SukbeomH/CxChanger/README.md

# [CxChanger]

저비용 예열식 다중 핫엔드 다중 재료 출력 솔루션 / Low-cost preheated multi-hotend multi-material printing solution.

[한국어](README.md) | [English](README.en.md)

Klipper 설정 파일: 기본 [`klipper/*.cfg`](klipper/)는 영어이며, 한국어 번역본은 [`klipper/ko/`](klipper/ko/), 영어 참조본은 [`klipper/en/`](klipper/en/)에 있습니다.

[CxChanger]는 FDM 3D 프린팅을 위한 다중 재료/다중 색상 솔루션입니다. 출력 중 서로 다른 필라멘트가 장착된 예열 완료 핫엔드 모듈을 툴 교체하여 빠른 다중 재료 출력을 구현합니다. 목표는 가능한 한 낮은 비용으로 단순하고 안정적인 다중 재료 출력을 구현하는 것입니다. 높은 호환성을 위해 툴 교체는 프린트헤드의 XY축 이동만으로 수행되며, 교체 구조는 핫엔드 모듈 자체와 독립적입니다. 따라서 핫엔드 모듈 고정 부품 등을 수정하면 다른 핫엔드도 호환시킬 수 있습니다.

프린트헤드

QQ20260404-193802

---

## 핵심 기능

- **자동 예열**: OrcaSlicer의 `Ooze Prevention`을 켜면, 사용자가 설정한 예열 시간에 맞춰 툴 교체 전에 예열 명령이 삽입됩니다. 교체 시 기존 핫엔드 모듈은 도크에 주차되고 대기 온도로 전환되며, 이미 예열된 핫엔드 모듈을 장착합니다. 다음 툴 교체까지의 시간이 가열 시간보다 짧으면 온도를 낮추지 않고 유지합니다.
- **언더액추에이티드 툴 교체 메커니즘**: 별도의 능동 구동 장치를 추가하지 않는 언더액추에이티드 설계입니다. 프린트헤드 자체의 XY축 이동과 도크의 기계적 상호작용을 이용해 툴 교체와 필라멘트 클램프/릴리스를 수행합니다.
- **자석식 Maxwell 운동학적 커플링**: 핫엔드 모듈 잠금에는 N52 자석과 [Maxwell 커플링](https://en.wikipedia.org/wiki/Kinematic_coupling) 위치 결정 구조를 함께 사용합니다. 프린트헤드 쪽에는 위치 결정 핀으로 구성된 세 개의 홈이 있고, 핫엔드 모듈 쪽에는 라운드 핀 머리로 구성된 볼이 있습니다. 자석으로 결합되면 핫엔드 모듈의 6자유도가 구속되며, 과구속이 발생하지 않습니다. 따라서 가공/조립 오차, 마모, 변형이 있어도 핫엔드 모듈이 스스로 유격을 줄이고 정밀하게 위치를 잡을 수 있습니다.
- **자동 노즐 오프셋 보정**: 보정기를 사용해 각 헤드의 XYZ축 오프셋을 T0 기준으로 보정합니다. [소형 볼 마이크로스위치 접촉식 노즐 오프셋 보정](https://github.com/Noisyfox/FoxChanger/tree/main/NozzleProbe) 또는 [비접촉 와전류 노즐 오프셋 보정](https://oshwhub.com/cxg01/project_lbabffjk)을 사용할 수 있습니다. 접촉식은 정확한 노즐 오프셋을 얻기 위해 노즐을 깨끗하게 청소해야 하며, 비접촉식은 노즐을 청소하지 않아도 사용할 수 있습니다. 매번 출력 전에 보정할 필요는 없고, 보통 최초 조립 직후나 노즐 충돌이 발생한 뒤에 보정합니다.

## 하드웨어 및 소프트웨어 요구 사항

### 하드웨어

- **프린터**: 원칙적으로 프린트헤드가 XY 이동을 할 수 있는 기종을 지원합니다. 예를 들면 Voron 2.4, Voron Trident, BigFish TT 등이 있습니다. 이 오픈소스 프로젝트는 프린트헤드와 기본 도크 설계만 제공합니다. 자신의 기종에 맞게 도크를 장착할 알루미늄 프로파일과 기타 호환 부품은 별도로 고정/수정해야 합니다.
- **메인보드**: 유선 가열 방식을 사용하므로 각 핫엔드 모듈에는 히터 카트리지와 서미스터가 하나씩 있습니다. 메인보드의 남는 포트를 활용하면 소수의 핫엔드 모듈을 확장할 수 있습니다. 더 많은 핫엔드 모듈을 확장하려면 [확장 보드](https://oshwhub.com/rayzark/project_qxihkkhj)를 제작해 히터봉 포트와 서미스터 포트를 늘려야 합니다.

### 소프트웨어

- **펌웨어**: 전체 툴 교체는 Klipper 매크로 명령으로 구현됩니다. 노즐 오프셋 보정이 필요하면 [toolchange](https://github.com/viesturz/klipper-toolchanger) 플러그인을 설치하고 자동 보정 매크로와 함께 사용해야 합니다.
- **슬라이서**: OrcaSlicer를 사용합니다. 다른 슬라이서는 직접 검토해야 합니다.

## 구성 개요

### 용어

- **프린트헤드(toolhead)**: XY 이동을 담당하며 핫엔드 모듈을 장착하는 캐리지입니다.
- **핫엔드 모듈(hotend module)**: 핫엔드, PTFE 튜브, 히터 및 서미스터 배선으로 구성된 교체 대상 물리 부품입니다.
- **툴(tool, `T0`-`T3`)**: Klipper와 OrcaSlicer에서 핫엔드 모듈을 선택하는 논리 식별자입니다. 이 문서에서 “툴 교체”는 한 핫엔드 모듈을 도크에 주차하고 다른 모듈을 장착하는 동작을 뜻합니다.
- **`UNTOOL`**: 현재 툴의 핫엔드 모듈을 도크에 주차하는 매크로입니다.

### 구성 부품

- 프린트헤드: 핫엔드를 제외한 나머지 부품입니다.
- 핫엔드 모듈: 핫엔드, PTFE 튜브, 히터, 서미스터 배선을 포함합니다.
- 도크: 분리된 핫엔드를 보관합니다. 보관 중인 핫엔드의 노즐을 막아 누출을 방지하고, 냉각 팬으로 보관 중인 핫엔드를 냉각합니다. 챔버가 없는 경우 측면 원심 팬 하나로 모든 핫엔드를 냉각하고, 챔버가 있는 경우 도크마다 축류 팬 하나를 사용합니다.

### 부품

#### 출력 버전

- 1.5 x 5 mm 원통 핀(직경 x 길이): Maxwell 커플링 위치 결정 홈 구성용(x6)
- 3 x 6 mm 라운드 핀(직경 x 길이): Maxwell 커플링 위치 결정 볼 구성용(핫엔드당 3개)
- 5 x 20 mm 내나사 라운드 핀(직경 x 길이): 도크에 장착해 익스트루더 아이들러 암을 벌리는 용도(도크당 1개)
- 6 x 4 mm N52 자석(직경 x 두께): 핫엔드 모듈을 프린트헤드와 도크에 부착하는 용도(핫엔드당 3개, 도크당 1개, 프린트헤드 3개)
- M3 x 6 접시머리 나사
- M3 x 25 나사
- M3 x 8 나사
- M3 x 10 나사
- M3 x 12 나사
- M3 x 14 나사
- M3 x 20 나사
- M2.5 x 16 나사
- M2 x 8 나사
- M3 x 4 x 4 열삽입 너트
- HGX 익스트루더 기어 세트
- 4020 블로워 팬
- 2510 축류 팬
- Omron 마이크로스위치
- 10 x 2 mm 접착식 내열 실리콘 스트립(폭 x 두께)

#### CNC 버전

[`5.5-version-bom.xlsx`](5.5-version-bom.xlsx)를 참고하십시오.

## 설치 및 설정 가이드

### printer.cfg

기존 `printer.cfg`의 본문은 그대로 사용할 수 있습니다. 제공된 `printer.cfg`의 형식과 아래 안내를 참고해 수정하거나, 제공된 파일을 그대로 사용하되 자신의 메인보드 핀에 맞게 변경해도 됩니다.

1. `toolchange.cfg`와 `calibration.cfg`를 include합니다.
2. 추가 핫엔드 모듈은 `extruder1` 형식을 참고해 정의합니다. 히터와 서미스터 핀은 자신의 메인보드 배선에 맞게 지정합니다. E0 익스트루더를 공용으로 사용하고, 나머지는 가상 익스트루더로 설정합니다.
3. 프로브는 고정 마이크로스위치를 사용합니다. 출력 시작 시 모든 핫엔드는 도크에 보관되고, 노즐은 내열 실리콘 패드로 막혀 있습니다. 목표 온도에 도달한 뒤에야 핫엔드를 집어 들기 때문에 초기 누출 문제가 해결되고 와이핑이 필요 없습니다. 베드 레벨링 시에는 핫엔드를 집지 않으므로 이때 마이크로스위치가 프린트헤드의 최저점입니다. 다른 레벨링 방식은 아직 지원하지 않습니다. 제공된 probe 관련 설정, 특히 베드 메시와 레벨링 설정을 참고하는 것을 권장합니다. 주된 차이는 레벨링 전에 집고 있던 핫엔드를 먼저 내려놓는 부분입니다.
4. 도크 냉각 팬 설정을 추가합니다. 도크 냉각 팬과 히트브레이크 냉각 팬이 연동하는 익스트루더 목록에 모든 익스트루더를 추가합니다.
5. `printer.cfg`의 `PRINT_START` 매크로를 수정해, 출력 전에 사용할 핫엔드 모듈이 자동으로 프라이밍/퍼지 라인을 만들도록 합니다.
6. `printer.cfg`의 `PRINT_END` 매크로를 수정합니다. `UNTOOL` 명령을 추가해 출력 완료 후 활성 핫엔드 모듈이 자동으로 도크에 주차되도록 합니다. 모든 핫엔드 히터를 끄는 명령도 추가합니다.

### toolchange.cfg

1. `toolchange.cfg`를 추가합니다. 성공적으로 추가하면 대시보드에 `T0`, `T1`, `T2`, `UNTOOL` 명령이 나타납니다. 좌표를 조정하기 전에는 누르지 마십시오. 바로 충돌할 수 있습니다. `T0`를 누르면 T0 핫엔드 모듈을 장착하고, T0가 장착된 상태에서 `T1`을 누르면 T0를 도크에 주차한 뒤 T1을 장착합니다. `UNTOOL`은 현재 핫엔드 모듈을 도크에 주차합니다.
2. 도크를 고정하고 도크 좌표를 조정합니다. 핫엔드를 프린트헤드에 수동으로 장착한 뒤 프린트헤드를 X축 가장 오른쪽으로 이동하고, 다시 앞쪽으로 이동합니다. 핫엔드 잠금 나사가 도크의 큰 구멍을 정확히 통과할 수 있는 위치에 첫 번째 도크를 고정합니다. 이 위치가 첫 번째 도크 좌표입니다. 이후 핫엔드를 제거하고 전체 홈을 수행한 다음, 다시 핫엔드를 프린트헤드에 장착합니다. 앞서 찾은 도크 위치로 프린트헤드를 천천히 이동시켜 잠금 나사가 도크의 큰 구멍을 통과하게 하고, 이때의 좌표를 기록해 `toolchange.cfg`의 T0 도크 위치에 입력합니다. 도크 하나는 30 mm 폭을 차지하므로 나머지 도크 좌표는 등차수열로 계산할 수 있습니다. 오차가 있으면 각 도크 좌표를 직접 미세 조정합니다.

   

3. 좌표를 올바르게 설정한 뒤에는 정상 속도를 주석 처리하고 테스트 속도의 주석을 해제해 저속으로 교체 테스트를 합니다. 정렬이 맞지 않으면 바로 비상정지를 누를 수 있도록 하기 위한 절차입니다.
4. 테스트 속도에서 교체가 정상 동작하면 테스트 속도를 다시 주석 처리하고 정상 속도의 주석을 해제합니다. 자신의 장비에 맞는 더 적절한 속도는 직접 테스트해 조정할 수 있습니다.

### calibration.cfg

1. [toolchange](https://github.com/viesturz/klipper-toolchanger) 플러그인을 다운로드합니다.
2. `calibration.cfg`를 추가합니다.
3. XYZ 홈을 수행합니다. 레벨링이 끝나면 보정기를 고정하고 `T0`를 눌러 첫 번째 핫엔드 모듈을 장착합니다. 노즐 끝이 보정기 중심 바로 위 약 1 mm 지점에 오도록 이동한 뒤, 이때의 좌표를 기록해 `calibration.cfg`의 보정기 좌표 위치에 입력합니다. 보정 중 도크 안의 다른 핫엔드 모듈과 충돌하지 않도록 도크 범위 밖의 안전 위치도 직접 정의해야 합니다.
4. 좌표 설정 후 `CALIBRATE_TOOL TOOL=_`을 입력하면 지정한 툴을 보정할 수 있습니다. T0를 먼저 보정해야 합니다. `CALIBRATE_ALL_TOOLS`를 입력하면 설정된 모든 툴을 보정할 수 있습니다. 보정 완료 후 오프셋은 자동 저장됩니다.

### OrcaSlicer

1. 프린터 프로필의 `Machine G-code`에서 `Machine start G-code`와 `Change filament G-code`를 수정하고, 핫엔드 모듈 수에 맞게 익스트루더를 추가합니다. 각 툴 교체의 필라멘트 리트랙션 길이도 설정합니다. 작성자는 2 mm로 설정했습니다.

- `Machine start G-code`, 자신의 핫엔드 모듈 수에 맞게 수정:

```Gcode
   ; 각 툴의 초기 레이어 온도와 실제 사용 여부를 개별 파라미터로 전달합니다.
PRINT_START BED=[first_layer_bed_temperature] INITIAL_TOOL=[initial_tool] T0_TEMP={nozzle_temperature_initial_layer[0]} T0_USED={is_extruder_used[0]} T1_TEMP={nozzle_temperature_initial_layer[1]} T1_USED={is_extruder_used[1]} T2_TEMP={nozzle_temperature_initial_layer[2]} T2_USED={is_extruder_used[2]} T3_TEMP={nozzle_temperature_initial_layer[3]} T3_USED={is_extruder_used[3]} T4_TEMP={nozzle_temperature_initial_layer[4]} T4_USED={is_extruder_used[4]}
```

- `Change filament G-code`:

```Gcode
M104 S{nozzle_temperature[next_extruder]} T{next_extruder}
T{next_extruder}
```

2. 공정 프로필의 멀티머티리얼 설정에서 `Prime Tower`를 켭니다. 필라멘트와 파라미터가 잘 조정되어 있고 모델에 빠르고 미세한 압출이 포함되지 않는다면, 모델을 도크 옆으로 옮기고 `Prime Tower`를 끈 상태로 출력하는 것도 시도할 수 있습니다. 같은 설정 영역에서 `Ooze Prevention`도 켭니다. 작성자는 연화 온도 -180, 예열 시간 35초로 설정했으며, 자신의 핫엔드 모듈 가열 속도에 맞게 수정해야 합니다.

## 주의 사항

- 출력 부품은 ABS로 출력하고, 벽 4겹과 60% 인필을 사용합니다.
- 익스트루더 스프링은 일반 익스트루더보다 더 강하게 조여야 합니다. 공간을 줄이기 위해 레버 암 길이가 짧아졌기 때문에, 같은 예압에서는 일반 익스트루더보다 클램프력이 낮습니다.
- 열전도 효율을 줄이기 위해 사용하는 TZ2.0 핫엔드는 히터 블록을 고정하는 나사 2개를 제거하고 측면 세트스크류만으로 고정해야 합니다.
- 자석은 도면대로 엄격하게 설치해야 합니다. 어떤 자석은 끝까지 눌러 넣고, 어떤 자석은 특정 면과 평면이 맞아야 합니다. 올바르게 조립되면 핫엔드 조립체 쪽 라운드 핀만 백플레이트 쪽 원통 핀 홈과 접촉하고, 자석 사이에는 약간의 간격이 남습니다. 그래야 Maxwell 커플링 위치 결정의 자동 유격 제거 기능이 작동합니다. 핫엔드를 흔들어 유격이 있는지 확인할 수 있습니다. 유격이 있으면 조립이 올바른지 확인해야 합니다. 출력 중 정밀도가 나빠지면 위치 결정 조립 상태를 확인하십시오. 자석 접착이 풀려 밀려 나오면서 반대쪽 자석과 접촉해 Maxwell 커플링이 무효화되는 문제가 발생하기 쉽습니다.
- 핫엔드 조립체를 도크 구멍에 걸기 위한 후크 나사는 12.9등급 육각렌치 볼트(컵 헤드)를 사용해야 도크 안에서 자석에 잘 붙습니다. 304 스테인리스 나사는 정상적으로 자석에 붙지 않습니다.
