SukbeomH/CxChanger/5.5-version-bom.xlsx

项目号 | 零件号 | 数量 | 价格 | 链接
HGX挤出齿轮套件 | 17 44双联齿轮 | 1 | 35.5 | https://item.taobao.com/item.htm?id=682175013983
 | 36齿挤出齿轮 | 2
 | 直径3长16圆柱销 | 2
 | 轴承外径6内径3厚2.5 | 4
 | 压簧 | 1
 | 直径3长24圆柱销 | 1
打印件 | 热端固定件 | 1
 | 停靠坞 | 数量根据自己需要来
 | 风道改 | 1
嘉立创拼版CNC | 顶部磁铁固定板 | 1 | 10 | 用上每个月两次的免费打样，加自己攻丝。不能自己攻丝的嘉立创1块钱攻一个（总共5个M3螺丝孔）
 | 弹簧撑板 | 1
 | 摆杆内（CNC） | 1
 | 摆杆内（CNC） | 1
 | 简化盖板 | 1
 | 打印头背板 | 1
 | 简化盖板 | 1
 | 铁氟龙管内径2外径4 | 热端固定件打印件内壁填充
 | 圆柱销直径1.5长5 | 用于构成麦克斯韦耦合定位的槽（×6） |  | https://detail.tmall.com/item.htm?id=1013104858939
 | 内螺纹圆头销M3外径5长18 | 装配于停靠坞上用于撑开挤出机摆臂（一个停靠坞1个） |  | https://detail.tmall.com/item.htm?id=864132087543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
 | 圆头销直径3长4 | 用于构成麦克斯韦耦合定位的球（一个热端3个） |  | https://detail.tmall.com/item.htm?id=868817943817
 | TZ2.0 | 数量根据自己需要来
 | N52磁铁直径6厚4 | 用于吸附热端模块到打印头上和停靠坞上（一个热端3个，一个停靠坞1个，打印头3个） |  | https://item.taobao.com/item.htm?id=968742198263
 | 2510风扇 | 1
 | 36圆饼步进电机 | 1
 | 微动开关 | 1
 | M4六角隔离柱10 | 2 |  | https://item.taobao.com/item.htm?abbucket=19&id=790190576194&ns=1&skuId=5961506598999&xxc=taobaoSearch
 | M4六角隔离柱14 | 1
 | M4带孔螺栓 | 1
 | 4020离心风扇 | 1
 | 杯头M3*8 | 2
 | M4螺母 | 1
 | 半圆头M3*22 | 7
 | 杯头M3*15 | 3
 | 杯头M2.5*14 | 2
 | M3螺母 | 5
 | 杯头M3*6 | 1
 | 杯头M3*10 | 3
 | 杯头M2*8 | 2
 | 停靠坞没有统一设计，这里不列举，螺丝种类自己判断
