SukbeomH/CxChanger/panelized-5.5-and-5.1-versions/5.1-cover-plate-PB1.step

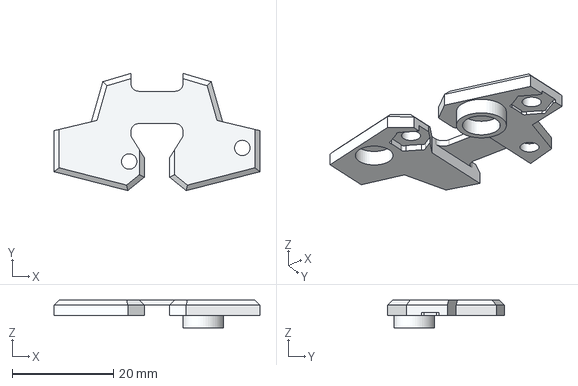
[picture p1: CAD file, 2026-07-12]
panelized-5.5-and-5.1-versions/5.1-cover-plate-PB1.step
40.8 x 23.2 x 5.50 mm
