SukbeomH/CxChanger/panelized-5.5-and-5.1-versions/5.1-idler-arm-PB2-thread-recognizable.step

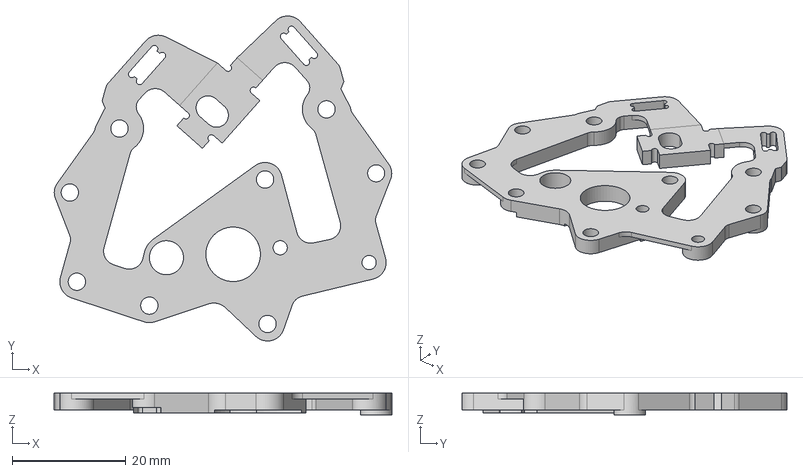
[picture p2: CAD file, 2026-07-12]
panelized-5.5-and-5.1-versions/5.1-idler-arm-PB2-thread-recognizable.step
59.4 x 57.2 x 3.80 mm
实体1 (2)
实体1 (4)
实体1 (1)
实体1 (3)
