SukbeomH/CxChanger/panelized-5.5-and-5.1-versions/5.1-backplate-2.5mm-belt-slot.step

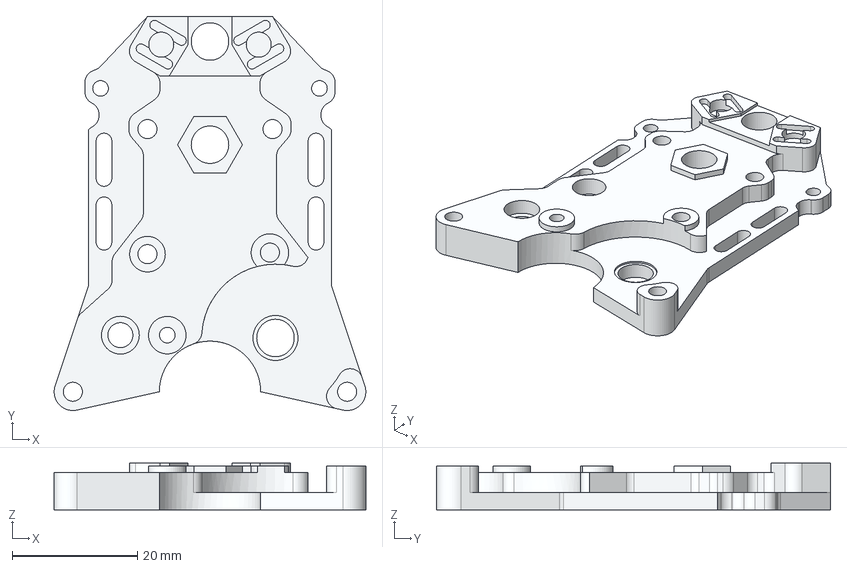
[picture p3: CAD file, 2026-07-12]
panelized-5.5-and-5.1-versions/5.1-backplate-2.5mm-belt-slot.step
49.8 x 63.0 x 7.50 mm
