SukbeomH/CxChanger/klipper/en/printer.cfg

[virtual_sdcard]
path: /usr/share/printer_data/gcodes

[pause_resume]

[display_status]

[gcode_macro CANCEL_PRINT]
description: Cancel the active print
rename_existing: CANCEL_PRINT_BASE
gcode:
  TURN_OFF_HEATERS
  CANCEL_PRINT_BASE
  G91
  G1 Z10 F600 ; Lift the nozzle 10 mm to avoid heat damage to the model
  UNTOOL
  M106 S0

[force_move]
enable_force_move: True

#####################################################################
#                               File includes                               #
#####################################################################
[include toolchange.cfg]
[include calibration.cfg]
#[include idm.cfg]
#####################################################################
#                               Mainboard configuration                               #
#####################################################################
[mcu]
serial:/dev/serial/by-id/usb-Klipper_stm32f407xx_37001E001650334636343620-if00

#[mcu host]
#serial: /tmp/klipper_host_mcu

#####################################################################
#                            Expansion board configuration                             #
#####################################################################
#[mcu expander]
# Enter the new board ID obtained in the first step here
#serial: /dev/serial/by-id/usb-Klipper_stm32f072xb_3F0035000357465036383420-if00
#####################################################################
#                            Printer model and acceleration                            #
#####################################################################
[printer]                       # printer settings
kinematics: corexy              # kinematics type, such as Cartesian or CoreXY; Cartesian uses cartesian
max_velocity: 400               # maximum printer speed
max_accel: 20000                # maximum acceleration
max_z_velocity: 30              # maximum Z-axis speed
max_z_accel: 300                # maximum Z-axis acceleration
square_corner_velocity: 5.0     # square-corner velocity; a smaller value helps reduce inertia from a heavy bed
#####################################################################
#                             Temperature monitoring                               #
#####################################################################
[temperature_sensor MCU]
sensor_type: temperature_mcu

[temperature_sensor FLY-Pi]
sensor_type: temperature_host

#[temperature_sensor Fly-C8p]     # FLY mainboard temperature, rename if desired
#sensor_type: temperature_mcu     # associated MCU, default

# [temperature_sensor Box]          # enclosure temperature; requires adding a temperature sensor, reference configuration
# sensor_type: ATC Semitec 104GT-2  # sensor type
# sensor_pin: PA4                   # signal port

#####################################################################
#             X/Y stepper settings (X/Y Stepper Settings)                 #
#####################################################################
#   B Motor ---- Motor A
#   |                  |
#   |------extruder-------|
#   |                  |
#   |                  |
#          front
#####################################################################
#                  X-axis stepper motor (B Motor)                            #
#####################################################################
[stepper_x]
step_pin: PB9                       # X-axis motor step pin
dir_pin: PE0                        # X-axis motor direction pin; verify direction on your machine, ! reverses direction
enable_pin: !PE1                    # X-axis motor enable pin; enable pins require ! or the motor will not work
rotation_distance: 40               # drive pulley circumference in mm; 2GT-20T is 40, 2GT-16T is 32
microsteps: 32                      # motor microstep setting; higher microsteps improve quality but increase controller load
full_steps_per_rotation: 200        # full steps per motor revolution; 1.8-degree motor: 200, 0.9-degree motor: 400
endstop_pin: PF1                    # physical X endstop pin
position_min: -5                   # minimum X-axis travel
position_endstop: 240              # endstop position
position_max: 240                  # maximum X-axis travel
homing_speed: 80                   # homing speed; maximum is 100
homing_retract_dist: 5             # retract distance after first homing-switch trigger
#--------------------------------------------------------------------
[tmc2209 stepper_x]                 # X driver configuration - TMC2209
uart_pin: PG13                      # UART port pin definition
interpolate: False                  # whether to enable 256-microstep interpolation; disabling is recommended, True enables and False disables
run_current: 1.2                   # motor run current, mA
sense_resistor: 0.110               # do not change the driver sense resistor
#stealthchop_threshold: 100          # stealthChop threshold; set to 0 if quiet mode is not needed
#####################################################################
#                  Y-axis stepper motor (A Motor)                            #
#####################################################################
[stepper_y]
step_pin: PB8                       # Y-axis motor step pin
dir_pin: PG11                      # Y-axis motor direction pin; verify direction on your machine, ! reverses direction
enable_pin: !PG12                   # Y-axis motor enable pin; enable pins require ! or the motor will not work
rotation_distance: 40               # drive pulley circumference in mm; 2GT-20T is 40, 2GT-16T is 32
microsteps: 32                      # motor microstep setting; higher microsteps improve quality but increase controller load
full_steps_per_rotation: 200        # full steps per motor revolution; 1.8-degree motor: 200, 0.9-degree motor: 400
endstop_pin: PC2
position_min: -33                   # minimum Y-axis travel
position_endstop: 230               # endstop position
position_max: 230                   # maximum Y-axis travel
homing_speed: 80                    # homing speed; maximum is 100
homing_retract_dist: 5              # retract distance after first homing-switch trigger 5
#--------------------------------------------------------------------
[tmc2209 stepper_y]                 # Y driver configuration - TMC2209
uart_pin: PG10                      # UART port pin definition
interpolate: False                  # whether to enable 256-microstep interpolation
run_current: 1.2                    # motor run current, mA
sense_resistor: 0.110               # do not change the driver sense resistor
#stealthchop_threshold: 100          # stealthChop threshold; set to 0 if quiet mode is not needed
#####################################################################
#                           Z-axis stepper motor                              #
#####################################################################
##    Z stepper motor - front left
[stepper_z]
step_pin: PC6                 # Z-axis motor step pin
dir_pin:  !PA15              # Z-axis motor direction pin; verify direction on your machine, ! reverses direction
enable_pin: !PD0              # Z-axis motor enable pin; enable pins require ! or the motor will not work
rotation_distance: 8          # lead screw lead is 8; adjust for your setup, three places must be changed in total
full_steps_per_rotation: 200  # full steps per motor revolution; 1.8-degree motor: 200, 0.9-degree motor: 400)
microsteps: 32                # motor microstep setting; higher microsteps improve quality but increase controller load
endstop_pin: probe:z_virtual_endstop            # endstop pin; normally-closed is recommended, add ! to invert, position io-1
position_min: -10             # minimum Z-axis travel; nozzle-cleaning setups usually need about -5
position_max: 200             # maximum Z-axis travel
homing_speed: 10               # homing speed, maximum 20
second_homing_speed: 3        # second homing speed, maximum 10
homing_retract_dist: 3        # retract distance
#--------------------------------------------------------------------
[tmc2208 stepper_z]
uart_pin: PA14                # driver UART port
interpolate: false            # 256-microstep interpolation
run_current: 0.8              # run current, mA
sense_resistor: 0.110         # do not change the driver sense resistor
#--------------------------------------------------------------------
##    Z1 stepper motor - rear
[stepper_z1]
step_pin: PC7                # Z1-axis motor step pin
dir_pin:  !PD3              # Z1-axis motor direction pin; verify direction on your machine, ! reverses direction
enable_pin: !PD4             # Z1-axis motor enable pin; enable pins require ! or the motor will not work
rotation_distance: 8          # lead screw lead is 8
full_steps_per_rotation: 200  # full steps per motor revolution; 1.8-degree motor: 200, 0.9-degree motor: 400
microsteps: 32                # motor microstep setting; higher microsteps improve quality but increase controller load
#--------------------------------------------------------------------
[tmc2208 stepper_z1]
uart_pin: PD1               # driver UART port
interpolate: false            # 256-microstep interpolation
run_current: 0.8              # run current, mA
sense_resistor: 0.110         # do not change the driver sense resistor
#--------------------------------------------------------------------
##    Z2 stepper motor - front right
[stepper_z2]
step_pin: PA8                 # Z2-axis motor step pin
dir_pin: !PD6                # Z2-axis motor direction pin; verify direction on your machine, ! reverses direction
enable_pin: !PD7             # Z2-axis motor enable pin; enable pins require ! or the motor will not work
rotation_distance: 8          # lead screw lead is 8
full_steps_per_rotation: 200  # full steps per motor revolution; 1.8-degree motor: 200, 0.9-degree motor: 400
microsteps: 32                # motor microstep setting; higher microsteps improve quality but increase controller load
#--------------------------------------------------------------------
[tmc2208 stepper_z2]
uart_pin: PD5                 # driver UART port
interpolate: false            # 256-microstep interpolation
run_current: 0.8              # run current, mA
sense_resistor: 0.110         # do not change the driver sense resistor
#####################################################################
#                     E0 extruder settings （E0 Settings）                   #
#####################################################################

[extruder]
step_pin: PD15                      # extruder motor step pin
dir_pin: PG7                        # extruder motor direction pin
enable_pin: !PG8                    # extruder motor enable pin
rotation_distance: 55               # rotation distance value
gear_ratio: 44:10, 37:17            # gear ratio; Galileo is 7.5:1 and this line should be commented out; BMG is 50:17, output shaft front, input shaft rear
microsteps: 32                      # motor microstep setting; higher microsteps improve quality but increase controller load
full_steps_per_rotation: 200        # full steps per revolution; 200 for 1.8 degrees, 400 for 0.9 degrees
nozzle_diameter: 0.400              # nozzle diameter
filament_diameter: 1.75             # filament diameter
heater_pin: PF7                     # heater cartridge pin
sensor_type: ATC Semitec 104GT-2    # sensor type  (#Generic 3950, ATC Semitec 104GT-2， PT1000)
sensor_pin: PA0                     # sensor pin, connected to ADC_0
min_temp: -273                      # minimum temperature; note that measured temperature outside the configured range triggers emergency stop
max_temp: 350                       # maximum temperature; note that measured temperature outside the configured range triggers emergency stop
max_power: 1.0                      # maximum power
min_extrude_temp: -273              # minimum extrusion temperature
#nozzle temperature PID calibration command：  "PID_CALIBRATE HEATER=extruder TARGET=245
#control = pid                # PID nozzle temperature auto-calibration item; commented after PID calibration completes
#pid_kp = 26.213              # PID nozzle temperature auto-calibration item; commented after PID calibration completes
#pid_ki = 1.304               # PID nozzle temperature auto-calibration item; commented after PID calibration completes
#pid_kd = 131.721             # PID nozzle temperature auto-calibration item; commented after PID calibration completes

#--------------------------------------------------------------------
[tmc2208 extruder]                  # extruder driver configuration
uart_pin: PG6                      # UART port pin definition
interpolate: False                  # whether to enable 256-microstep interpolation; True enables and False disables
run_current: 0.8                    # motor run current
sense_resistor: 0.110               # do not change the driver sense resistor
#stealthchop_threshold: 500          # stealthChop threshold; not recommended for the extruder, set to 0 if quiet mode is not needed

#####################################################################
#                     E1 extruder settings （E1 Settings）                   #
#####################################################################

[extruder1]
nozzle_diameter: 0.400              # nozzle diameter
filament_diameter: 1.75             # filament diameter
heater_pin: PF6                     # heater cartridge pin
sensor_type: ATC Semitec 104GT-2    # sensor type  (#Generic 3950, ATC Semitec 104GT-2， PT1000)
sensor_pin: PC1                     # sensor pin, connected to ADC_0
min_temp: -273                      # minimum temperature; note that measured temperature outside the configured range triggers emergency stop
max_temp: 350                       # maximum temperature; note that measured temperature outside the configured range triggers emergency stop
max_power: 1.0                      # maximum power
min_extrude_temp: 180               # minimum extrusion temperature; the extruder can extrude only after reaching this temperature
#nozzle temperature PID calibration command：  "PID_CALIBRATE HEATER=extruder1 TARGET=245
#control = pid                # PID nozzle temperature auto-calibration item; commented after PID calibration completes
#pid_kp = 26.213              # PID nozzle temperature auto-calibration item; commented after PID calibration completes
#pid_ki = 1.304               # PID nozzle temperature auto-calibration item; commented after PID calibration completes
#pid_kd = 131.721             # PID nozzle temperature auto-calibration item; commented after PID calibration completes

#####################################################################
#                     E2 extruder settings （E2 Settings）                   #
#####################################################################

[extruder2]
nozzle_diameter: 0.400              # nozzle diameter
filament_diameter: 1.75             # filament diameter
heater_pin: PE6                     # heater cartridge pin
sensor_type: ATC Semitec 104GT-2    # sensor type  (#Generic 3950, ATC Semitec 104GT-2， PT1000)
sensor_pin: PC0                     # sensor pin, connected to ADC_0
min_temp: -273                      # minimum temperature; note that measured temperature outside the configured range triggers emergency stop
max_temp: 350                       # maximum temperature; note that measured temperature outside the configured range triggers emergency stop
max_power: 1.0                      # maximum power
min_extrude_temp: 180               # minimum extrusion temperature; the extruder can extrude only after reaching this temperature
#nozzle temperature PID calibration command：  "PID_CALIBRATE HEATER=extruder2 TARGET=245
#control = pid                # PID nozzle temperature auto-calibration item; commented after PID calibration completes
#pid_kp = 26.213              # PID nozzle temperature auto-calibration item; commented after PID calibration completes
#pid_ki = 1.304               # PID nozzle temperature auto-calibration item; commented after PID calibration completes
#pid_kd = 131.721             # PID nozzle temperature auto-calibration item; commented after PID calibration completes

#####################################################################
#                     E3 extruder settings （E3 Settings）                   #
#####################################################################

[extruder3]
nozzle_diameter: 0.400              # nozzle diameter
filament_diameter: 1.75             # filament diameter
heater_pin: PE5                     # heater cartridge pin
sensor_type: ATC Semitec 104GT-2    # sensor type  (#Generic 3950, ATC Semitec 104GT-2， PT1000)
sensor_pin: PF10                    # sensor pin, connected to ADC_0
min_temp: -273                      # minimum temperature; note that measured temperature outside the configured range triggers emergency stop
max_temp: 350                       # maximum temperature; note that measured temperature outside the configured range triggers emergency stop
max_power: 1.0                      # maximum power
min_extrude_temp: 180               # minimum extrusion temperature; the extruder can extrude only after reaching this temperature
#nozzle temperature PID calibration command：  "PID_CALIBRATE HEATER=extruder3 TARGET=245
#control = pid                # PID nozzle temperature auto-calibration item; commented after PID calibration completes
#pid_kp = 26.213              # PID nozzle temperature auto-calibration item; commented after PID calibration completes
#pid_ki = 1.304               # PID nozzle temperature auto-calibration item; commented after PID calibration completes
#pid_kd = 131.721             # PID nozzle temperature auto-calibration item; commented after PID calibration completes

#####################################################################
#                            heated bed configuration                                #
#####################################################################

[heater_bed]
heater_pin: PE3              # heated bed port
sensor_type: Generic 3950    # heated bed sensor type
sensor_pin:  PF3             # heated bed sensor port
max_power: 1.0               # heated bed power
min_temp: -273                  # minimum temperature; note that measured temperature outside the configured range triggers emergency stop
max_temp: 100                # maximum temperature; note that measured temperature outside the configured range triggers emergency stop
# heated bed temperature PID calibration command：  "PID_CALIBRATE HEATER=heater_bed TARGET=100"
#control: pid                # PID heated-bed temperature auto-calibration item; commented after PID calibration completes
#pid_kp: 58.437              # PID heated-bed temperature auto-calibration item; commented after PID calibration completes
#pid_ki: 2.347               # PID heated-bed temperature auto-calibration item; commented after PID calibration completes
#pid_kd: 363.769             # PID heated-bed temperature auto-calibration item; commented after PID calibration completes

#####################################################################
#                            fan configuration                                #
#####################################################################
[fan]                        # part-cooling fan
pin: PF8                     # signal port
kick_start_time: 0.5         # startup time; do not change
off_below: 0.10              # do not change
#--------------------------------------------------------------------
[heater_fan hotend_fan]
pin: PF9                     # signal port
max_power: 1                 # maximum speed
kick_start_time: 0.5         # startup time; do not change
heater: extruder,extruder1,extruder2,extruder3             # associated device: extruder
heater_temp: 50              # extruder temperature at which the fan starts
fan_speed: 0.6               # fan speed
#--------------------------------------------------------------------
[heater_fan dock_fan]
pin: PA2                     # signal port
max_power: 1.0               # maximum speed
kick_start_time: 0.5         # startup time; do not change
heater: extruder,extruder1,extruder2,extruder3              # associated device: extruder
heater_temp: 50              # extruder temperature at which the fan starts
fan_speed: 1.0               # fan speed
#--------------------------------------------------------------------

[controller_fan driver_fan]
pin: PA1                     # replace with the actual controller-fan pin on your board
max_power: 1.0              # full-speed fan power
idle_timeout: 60            # delay after steppers become idle (seconds)

#####################################################################
#                           leveling sensor                               #
#####################################################################
[probe]
pin: PF2
x_offset: 2.88                  # X-axis sensor offset relative to nozzle
y_offset: 11.63                 # Y-axis sensor offset relative to nozzle
#z_offset: 5.07              # Z-axis sensor offset relative to nozzle
#PROBE_CALIBRATE, probe calibration
speed: 10                     # leveling speed
samples: 3                   # number of samples
samples_result: median       # sample result method; default median
sample_retract_dist: 3.0     # leveling retract distance
lift_speed:8                # lift speed
samples_tolerance: 0.005     # sample tolerance; too-small values may increase sample count
samples_tolerance_retries: 6 # number of retries after exceeding tolerance

#####################################################################
#                               homing                                #
#####################################################################
[homing_override]
axes: z
set_position_z: 0
gcode:
    G91
    G1 Z10 F600
    G90

    # check whether X is homed; home it if not
    {% if "X" not in printer.toolhead.homed_axes %}
        G28 Y
        G91
        G1 Y-40 F2400
        G90
    {% endif %}
    M400

    # check whether X is homed; home it if not
    {% if "X" not in printer.toolhead.homed_axes %}
        G28 X
        G91
        G1 X-5 F1200
        G90
    {% endif %}

    UNTOOL  # run your tool-unload macro

    # move to the center of the bed for Z homing; adjust X150 Y150 for your bed size
    G0 X{ printer.toolhead.axis_maximum.x/2 } Y{ printer.toolhead.axis_maximum.y/2 } F6000

    # perform actual Z homing
    G28 Z

    # lift slightly after homing
    G1 Z20 F600

#####################################################################
#   3-Z leveling
#####################################################################
[z_tilt]
# z_positions: physical lead-screw coordinates, rotation-center points
# imagine the XY coordinate of the point where the nozzle would be directly above the lead screw.
# Note: these points are usually outside the print area.
z_positions:
    -10, -5           # lead screw 1 (stepper_z) physical position
    117.5, 255        # lead screw 2 (stepper_z1)  physical position
    245, 10           # lead screw 3 (stepper_z2) physical position

# points: probe measurement points, where the probe touches the bed
points:
    10, 10            # first measurement point (near the rear-left lead screw)
    117.5, 205        # second measurement point (near the rear-right lead screw)
    225, 10           # third measurement point (near the front-center lead screw)

speed: 400            # move speed between measurements
horizontal_move_z: 10 # lift height before measurement
retries: 6            # allowed retry count until accuracy is reached
retry_tolerance: 0.01 # accuracy requirement
#####################################################################
#                              bed mesh calibration
#####################################################################
[bed_mesh]
speed: 300                   # calibration speed
horizontal_move_z: 10        # Z lift height before the probe moves to the next point
mesh_min: 10,10              # minimum calibration point coordinates, X and Y
mesh_max: 220, 225           # maximum calibration point coordinates, X and Y
probe_count: 5,5             # number of sample points; 4x4 is 16 points
mesh_pps: 2,2                # additional interpolated sample points
algorithm: bicubic           # algorithm model
bicubic_tension: 0.2         # do not change the algorithm interpolation setting

#####################################################################
#                    park the active tool (hotend module) before probing
#####################################################################
[gcode_macro Z_TILT_ADJUST]
rename_existing: Z_TILT_ADJUST_BASE
gcode:
    UNTOOL        # first make sure no tool is attached
    Z_TILT_ADJUST_BASE {rawparams}  # then run the original leveling command

[gcode_macro BED_MESH_CALIBRATE]
rename_existing: BED_MESH_CALIBRATE_BASE
gcode:
    UNTOOL        # first make sure no tool is attached
    BED_MESH_CALIBRATE_BASE {rawparams} # then run the original leveling command

#####################################################################
#                              Accelerometer
#####################################################################
[lis2dw]
i2c_address: 25
# i2c_mcu: toolhead          # Defaults to the main MCU when omitted
# i2c_bus: i2c3              # Try hardware I2C if software I2C fails
i2c_speed: 400000
i2c_software_scl_pin: PA9
i2c_software_sda_pin: PA10

[resonance_tester]
accel_chip: lis2dw
accel_per_hz: 50
probe_points: 120, 120, 20   # Set to the bed center with a safe Z height around 20 mm

[input_shaper]
# Leave empty until resonance calibration writes values through SAVE_CONFIG.

#####################################################################
#                           custom G-code macros                            #
#####################################################################

[gcode_macro PRINT_START]
description: Print-start macro: homing, leveling, independent material temperatures, and ordered priming lines
gcode:
    # ==========================================
    # 1. Priming-line parameters
    # ==========================================
    {% set cfg_start_x = params.START_X|default(10.0)|float %}
    {% set cfg_start_y = params.START_Y|default(5.0)|float %}
    {% set cfg_offset_y = params.OFFSET_Y|default(2.0)|float %}
    {% set cfg_length = params.LENGTH|default(50.0)|float %}
    {% set cfg_pre_extrude = params.PRE_EXTRUDE|default(3.0)|float %}
    {% set cfg_retract = 0 %}
    {% set cfg_speed_xy = 24000 %}
    {% set cfg_speed_z = 3000 %}

    # ==========================================
    # 2. Read slicer parameters and identify tools that are actually used
    # ==========================================
    {% set BED_TEMP = params.BED|default(60)|float %}
    {% set INITIAL_TOOL = params.INITIAL_TOOL|default("0")|string %}
    {% set ns = namespace(tools="", temps="") %}

    # Check the five supported slicer slots, T0 through T4.
    {% for i in range(5) %}
        {% set temp_key = 'T' ~ i ~ '_TEMP' %}
        {% set used_key = 'T' ~ i ~ '_USED' %}
        {% set ext_name = "extruder" if i == 0 else "extruder" ~ i %}

        {% if temp_key in params and ext_name in printer.heaters.available_heaters %}
            {% set t_val = params[temp_key]|float %}
            {% set is_used = params[used_key]|default("1")|string|lower %}
            {% if t_val > 0 and (is_used == "1" or is_used == "true") %}
                {% set ns.tools = ns.tools ~ i ~ "," %}
                {% set ns.temps = ns.temps ~ t_val ~ "," %}
            {% endif %}
        {% endif %}
    {% endfor %}

    {% set tool_list = ns.tools.strip(',').split(',') %}
    {% set temp_list = ns.temps.strip(',').split(',') %}

    # Fallback: heat only the initial tool to 200 C if no valid tool was matched.
    {% if tool_list|length == 1 and tool_list[0] == "" %}
        {% set tool_list = [INITIAL_TOOL] %}
        {% set temp_list = [200.0] %}
    {% endif %}

    # ==========================================
    # 3. Preheat the bed, home, and level
    # ==========================================
    BED_MESH_CLEAR
    M140 S{BED_TEMP}
    G28
    Z_TILT_ADJUST
    G28 Z
    G1 Z20 F{cfg_speed_z}
    BED_MESH_PROFILE LOAD=default
    M190 S{BED_TEMP}

    # ==========================================
    # 4. Heat all used tools to their independent temperatures
    # ==========================================
    # Start all heaters concurrently.
    {% for i in range(tool_list|length) %}
        {% if tool_list[i] != "" and temp_list[i] != "" %}
            M104 S{temp_list[i]} T{tool_list[i]}
        {% endif %}
    {% endfor %}

    # Then wait for each heater to reach its target.
    {% for i in range(tool_list|length) %}
        {% if tool_list[i] != "" and temp_list[i] != "" %}
            M109 S{temp_list[i]} T{tool_list[i]}
        {% endif %}
    {% endfor %}

    # ==========================================
    # 5. Switch tools in order and create priming lines
    # ==========================================
    SAVE_GCODE_STATE NAME=print_start_state
    G90
    G92 E0
    {% set ns_line = namespace(line_index=0) %}

    # 5.1 Prime non-initial tools first.
    {% for tool in tool_list %}
        {% if tool != "" and tool != INITIAL_TOOL %}
            T{tool}
            {% set current_y = cfg_start_y + (ns_line.line_index * cfg_offset_y) %}

            G1 Z5.0 F{cfg_speed_z}
            G1 X{cfg_start_x} Y{current_y} F{cfg_speed_xy}
            G1 Z0.28 F1500

            G91
            G1 E{cfg_pre_extrude} F300
            G1 X{cfg_length * 0.6} E{cfg_length * 0.12} F1000
            G1 X{cfg_length * 0.4} E{cfg_length * 0.05} F1500
            G1 E-{cfg_retract} F2100
            G1 Z2.0 F{cfg_speed_z}

            G90
            G92 E0
            M104 S0 T{tool}
            {% set ns_line.line_index = ns_line.line_index + 1 %}
        {% endif %}
    {% endfor %}

    # 5.2 Prime the initial tool last so it is ready to print immediately.
    {% if INITIAL_TOOL in tool_list %}
        T{INITIAL_TOOL}
        {% set current_y = cfg_start_y + (ns_line.line_index * cfg_offset_y) %}

        G1 Z5.0 F{cfg_speed_z}
        G1 X{cfg_start_x} Y{current_y} F{cfg_speed_xy}
        G1 Z0.28 F1500

        G91
        G1 E{cfg_pre_extrude} F300
        G1 X{cfg_length * 0.6} E{cfg_length * 0.12} F1000
        G1 X{cfg_length * 0.4} E{cfg_length * 0.05} F1500
        G1 E-{cfg_retract} F2100
        G1 Z2.0 F{cfg_speed_z}

        G90
        G92 E0
    {% endif %}

    # ==========================================
    # 6. Restore state and apply the initial-tool offset
    # ==========================================
    RESTORE_GCODE_STATE NAME=print_start_state

    {% if INITIAL_TOOL in tool_list %}
        {% set svv = printer.save_variables.variables %}
        {% set off_x = svv["t" ~ INITIAL_TOOL ~ "_offset_x"] | default(0.0) | float %}
        {% set off_y = svv["t" ~ INITIAL_TOOL ~ "_offset_y"] | default(0.0) | float %}
        {% set off_z = svv["t" ~ INITIAL_TOOL ~ "_offset_z"] | default(0.0) | float %}

        SET_GCODE_OFFSET X={off_x} Y={off_y} Z={off_z} MOVE=0
        { action_respond_info("Initial tool T" ~ INITIAL_TOOL ~ " offset applied: X=" ~ off_x ~ " Y=" ~ off_y ~ " Z=" ~ off_z) }
    {% endif %}

    { action_respond_info("Priming complete. Current tool is T" ~ INITIAL_TOOL ~ "; ready to print.") }
#--------------------------------------------------------------------
[gcode_macro PRINT_END]
description: Print-end macro: park the active tool, turn off heaters, and lower the bed for easy part removal
gcode:
    # 1. get the configured printer bounds
    {% set max_x = printer.configfile.config["stepper_x"]["position_max"]|float %}
    {% set max_y = printer.configfile.config["stepper_y"]["position_max"]|float %}
    {% set max_z = printer.configfile.config["stepper_z"]["position_max"]|float %}

    # 2. park the active tool (hotend module) and reset offsets
    UNTOOL
    SET_GCODE_OFFSET X=0 Y=0 Z=0

    M400                              # wait for buffer to clear
    G92 E0                            # reset extruder position counter

    # 3. perform a small safe lift first, in relative coordinates
    G91                               # relative positioning
    # lift 5 mm if it does not exceed maximum height
    {% if printer.toolhead.position.z < (max_z - 5) %}
        G0 Z5 F3600
    {% endif %}

    # 4. turn off all heaters and fans
    M104 S0 T0
    M104 S0 T1
    M104 S0 T2
    M104 S0 T3
    M140 S0                           # turn off heated bed
    M106 S0                           # turn off part-cooling fan

    # 5. move to the part-removal position, in absolute coordinates
    G90                               # switch back to absolute coordinates
    {% set safe_z = max_z - 10 %}

    G0 X{max_x-5} Y{max_y-5} Z{safe_z} F6000

    # 6. post-processing
    M400                              # wait for movement to complete
    BED_MESH_CLEAR                    # clear bed mesh
    # M84                             # Optional: uncomment this line to disable motors for easier manual part removal

    { action_respond_info("Print complete. The bed has been lowered; remove the part.") }
#*# <---------------------- SAVE_CONFIG ---------------------->
#*# DO NOT EDIT THIS BLOCK OR BELOW. The contents are auto-generated.
#*#
#*# [heater_bed]
#*# control = pid
#*# pid_kp = 18.892
#*# pid_ki = 0.396
#*# pid_kd = 225.286
#*#
#*# [extruder]
#*# control = pid
#*# pid_kp = 23.799
#*# pid_ki = 6.102
#*# pid_kd = 23.204
#*#
#*# [probe]
#*# z_offset = -1.225
#*#
#*# [extruder1]
#*# control = pid
#*# pid_kp = 26.493
#*# pid_ki = 8.831
#*# pid_kd = 19.870
#*#
#*# [extruder2]
#*# control = pid
#*# pid_kp = 46.880
#*# pid_ki = 10.081
#*# pid_kd = 54.499
#*#
#*# [extruder3]
#*# control = pid
#*# pid_kp = 40.250
#*# pid_ki = 13.417
#*# pid_kd = 30.187
#*#
#*# [bed_mesh default]
#*# version = 1
#*# points =
#*# 	  -0.014690, -0.052190, -0.025940, -0.054690, -0.050940
#*# 	  -0.052190, -0.025940, -0.010940, -0.010940, 0.004060
#*# 	  -0.120940, -0.043440, -0.013440, 0.030310, 0.100310
#*# 	  -0.197190, -0.100940, -0.027190, 0.055310, 0.155310
#*# 	  -0.245940, -0.087190, 0.022810, 0.120310, 0.264060
#*# x_count = 5
#*# y_count = 5
#*# mesh_x_pps = 2
#*# mesh_y_pps = 2
#*# algo = bicubic
#*# tension = 0.2
#*# min_x = 10.0
#*# max_x = 220.0
#*# min_y = 10.0
#*# max_y = 225.0
#*#
#*# [input_shaper]
#*# shaper_type_x = mzv
#*# shaper_freq_x = 94.4
#*# shaper_type_y = mzv
#*# shaper_freq_y = 66.4
