SukbeomH/CxChanger/klipper/ko/printer.cfg

[virtual_sdcard]
path: /usr/share/printer_data/gcodes

[pause_resume]

[display_status]

[gcode_macro CANCEL_PRINT]
description: 현재 출력 취소
rename_existing: CANCEL_PRINT_BASE
gcode:
  TURN_OFF_HEATERS
  CANCEL_PRINT_BASE
  G91
  G1 Z10 F600 ; 모델의 열 손상을 방지하도록 노즐을 10 mm 상승
  UNTOOL
  M106 S0

[force_move]
enable_force_move: True

#####################################################################
#                               파일 include                               #
#####################################################################
[include toolchange.cfg]
[include calibration.cfg]
#[include idm.cfg]
#####################################################################
#                               메인보드 설정                               #
#####################################################################
[mcu]
serial:/dev/serial/by-id/usb-Klipper_stm32f407xx_37001E001650334636343620-if00

#[mcu host]
#serial: /tmp/klipper_host_mcu

#####################################################################
#                            확장 보드 설정                             #
#####################################################################
#[mcu expander]
# 첫 단계에서 얻은 새 보드 ID를 여기에 입력
#serial: /dev/serial/by-id/usb-Klipper_stm32f072xb_3F0035000357465036383420-if00
#####################################################################
#                            프린터 기종 및 가속도                            #
#####################################################################
[printer]                       # 프린터 설정
kinematics: corexy              # 키네마틱 구조: Cartesian, CoreXY 등. Cartesian은 cartesian 사용
max_velocity: 400               # 프린터 최대 속도
max_accel: 20000                # 최대 가속도
max_z_velocity: 30              # Z축 최대 속도
max_z_accel: 300                # Z축 최대 가속도
square_corner_velocity: 5.0     # 스퀘어 코너 속도; 값을 낮추면 무거운 베드 관성 영향을 줄일 수 있음
#####################################################################
#                             온도 모니터링                               #
#####################################################################
[temperature_sensor MCU]
sensor_type: temperature_mcu

[temperature_sensor FLY-Pi]
sensor_type: temperature_host

#[temperature_sensor Fly-C8p]     # FLY 메인보드 온도, 필요 시 이름 변경 가능
#sensor_type: temperature_mcu     # 연결된 MCU, 기본값

# [temperature_sensor Box]          # 챔버 내부 온도; 온도 센서 추가 필요, 참고 설정
# sensor_type: ATC Semitec 104GT-2  # 센서 유형
# sensor_pin: PA4                   # 신호 포트

#####################################################################
#             X/Y 스테퍼 설정 (X/Y Stepper Settings)                 #
#####################################################################
#   B Motor ---- Motor A
#   |                  |
#   |------익스트루더-------|
#   |                  |
#   |                  |
#          정면
#####################################################################
#                  X축 스테퍼 모터 (B Motor)                            #
#####################################################################
[stepper_x]
step_pin: PB9                       # X축 모터 step 핀
dir_pin: PE0                        # X축 모터 방향 핀; 실제 장비에서 방향 확인, !는 방향 반전
enable_pin: !PE1                    # X축 모터 enable 핀; enable 핀에는 !가 필요
rotation_distance: 40               # 구동 풀리 둘레 mm; 2GT-20T는 40, 2GT-16T는 32
microsteps: 32                      # 모터 마이크로스텝 설정; 높을수록 컨트롤러 부하 증가
full_steps_per_rotation: 200        # 모터 1회전 스텝 수; 1.8도 모터 200, 0.9도 모터 400
endstop_pin: PF1                    # 물리 X 엔드스톱 핀
position_min: -5                   # X축 최소 이동 범위
position_endstop: 240              # 엔드스톱 위치
position_max: 240                  # X축 최대 이동 범위
homing_speed: 80                   # 홈 속도; 최대 100
homing_retract_dist: 5             # retract distance after first homing-switch trigger
#--------------------------------------------------------------------
[tmc2209 stepper_x]                 # X 드라이버 설정 - TMC2209
uart_pin: PG13                      # UART 포트 핀 정의
interpolate: False                  # 256 마이크로스텝 보간 사용 여부; 끄는 것을 권장, True는 켬, False는 끔
run_current: 1.2                   # 모터 구동 전류, mA
sense_resistor: 0.110               # 드라이버 sense 저항은 변경하지 마십시오
#stealthchop_threshold: 100          # stealthChop 임계값; 저소음이 필요 없으면 0으로 설정
#####################################################################
#                  Y축 스테퍼 모터 (A Motor)                            #
#####################################################################
[stepper_y]
step_pin: PB8                       # Y축 모터 step 핀
dir_pin: PG11                      # Y축 모터 방향 핀; 실제 장비에서 방향 확인, !는 방향 반전
enable_pin: !PG12                   # Y축 모터 enable 핀; enable 핀에는 !가 필요
rotation_distance: 40               # 구동 풀리 둘레 mm; 2GT-20T는 40, 2GT-16T는 32
microsteps: 32                      # 모터 마이크로스텝 설정; 높을수록 컨트롤러 부하 증가
full_steps_per_rotation: 200        # 모터 1회전 스텝 수; 1.8도 모터 200, 0.9도 모터 400
endstop_pin: PC2
position_min: -33                   # Y축 최소 이동 범위
position_endstop: 230               # 엔드스톱 위치
position_max: 230                   # Y축 최대 이동 범위
homing_speed: 80                    # 홈 속도; 최대 100
homing_retract_dist: 5              # 첫 홈 스위치 트리거 후 후퇴 거리 5
#--------------------------------------------------------------------
[tmc2209 stepper_y]                 # Y 드라이버 설정 - TMC2209
uart_pin: PG10                      # UART 포트 핀 정의
interpolate: False                  # 256 마이크로스텝 보간 사용 여부
run_current: 1.2                    # 모터 구동 전류, mA
sense_resistor: 0.110               # 드라이버 sense 저항은 변경하지 마십시오
#stealthchop_threshold: 100          # stealthChop 임계값; 저소음이 필요 없으면 0으로 설정
#####################################################################
#                           Z축 스테퍼 모터                              #
#####################################################################
##    Z 스테퍼 모터 - 좌전방
[stepper_z]
step_pin: PC6                 # Z축 모터 step 핀
dir_pin:  !PA15              # Z축 모터 방향 핀; 실제 장비에서 방향 확인, !는 방향 반전
enable_pin: !PD0              # Z축 모터 enable 핀; enable 핀에는 !가 필요
rotation_distance: 8          # 리드스크류 리드 8; 실제 사용 상황에 맞게 수정, 총 3곳 수정 필요
full_steps_per_rotation: 200  # 모터 1회전 스텝 수; 1.8도 모터 200, 0.9도 모터 400)
microsteps: 32                # 모터 마이크로스텝 설정; 높을수록 컨트롤러 부하 증가
endstop_pin: probe:z_virtual_endstop            # 엔드스톱 핀; NC 권장, !를 추가해 반전, 위치 io-1
position_min: -10             # Z축 최소 이동 범위; 노즐 청소 설정에는 약 -5 필요
position_max: 200             # Z축 최대 이동 범위
homing_speed: 10               # 홈 속도, 최대 20
second_homing_speed: 3        # 2차 홈 속도, 최대 10
homing_retract_dist: 3        # 후퇴 거리
#--------------------------------------------------------------------
[tmc2208 stepper_z]
uart_pin: PA14                # driver UART port
interpolate: false            # 256 마이크로스텝 보간
run_current: 0.8              # 구동 전류, mA
sense_resistor: 0.110         # 드라이버 sense 저항은 변경하지 마십시오
#--------------------------------------------------------------------
##    Z1 스테퍼 모터 - 후방
[stepper_z1]
step_pin: PC7                # Z1축 모터 step 핀
dir_pin:  !PD3              # Z1축 모터 방향 핀; 실제 장비에서 방향 확인, !는 방향 반전
enable_pin: !PD4             # Z1축 모터 enable 핀; enable 핀에는 !가 필요
rotation_distance: 8          # 리드스크류 리드 8
full_steps_per_rotation: 200  # 모터 1회전 스텝 수; 1.8도 모터 200, 0.9도 모터 400
microsteps: 32                # 모터 마이크로스텝 설정; 높을수록 컨트롤러 부하 증가
#--------------------------------------------------------------------
[tmc2208 stepper_z1]
uart_pin: PD1               # driver UART port
interpolate: false            # 256 마이크로스텝 보간
run_current: 0.8              # 구동 전류, mA
sense_resistor: 0.110         # 드라이버 sense 저항은 변경하지 마십시오
#--------------------------------------------------------------------
##    Z2 스테퍼 모터 - 우전방
[stepper_z2]
step_pin: PA8                 # Z2축 모터 step 핀
dir_pin: !PD6                # Z2축 모터 방향 핀; 실제 장비에서 방향 확인, !는 방향 반전
enable_pin: !PD7             # Z2축 모터 enable 핀; enable 핀에는 !가 필요
rotation_distance: 8          # 리드스크류 리드 8
full_steps_per_rotation: 200  # 모터 1회전 스텝 수; 1.8도 모터 200, 0.9도 모터 400
microsteps: 32                # 모터 마이크로스텝 설정; 높을수록 컨트롤러 부하 증가
#--------------------------------------------------------------------
[tmc2208 stepper_z2]
uart_pin: PD5                 # driver UART port
interpolate: false            # 256 마이크로스텝 보간
run_current: 0.8              # 구동 전류, mA
sense_resistor: 0.110         # 드라이버 sense 저항은 변경하지 마십시오
#####################################################################
#                     E0 익스트루더 설정 （E0 Settings）                   #
#####################################################################

[extruder]
step_pin: PD15                      # 익스트루더 모터 step 핀
dir_pin: PG7                        # 익스트루더 모터 방향 핀
enable_pin: !PG8                    # 익스트루더 모터 enable 핀
rotation_distance: 55               # rotation distance 값
gear_ratio: 44:10, 37:17            # 기어비; Galileo는 7.5:1이고 이 줄은 주석 처리, BMG는 50:17, 출력축 전방, 입력축 후방
microsteps: 32                      # 모터 마이크로스텝 설정; 높을수록 품질은 좋아지지만 컨트롤러 부하가 증가
full_steps_per_rotation: 200        # 1회전 스텝 수; 200은 1.8도, 400은 0.9도
nozzle_diameter: 0.400              # 노즐 직경
filament_diameter: 1.75             # 필라멘트 직경
heater_pin: PF7                     # 히터 카트리지 핀
sensor_type: ATC Semitec 104GT-2    # 센서 유형  (#Generic 3950, ATC Semitec 104GT-2， PT1000)
sensor_pin: PA0                     # 센서 핀, ADC_0에 연결
min_temp: -273                      # 최소 온도; 측정 온도가 설정 범위를 벗어나면 긴급 정지 트리거
max_temp: 350                       # 최대 온도; 측정 온도가 설정 범위를 벗어나면 긴급 정지 트리거
max_power: 1.0                      # 최대 출력
min_extrude_temp: -273              # 최소 압출 온도
#노즐 온도 PID 보정 명령：  "PID_CALIBRATE HEATER=extruder TARGET=245
#control = pid                # PID 노즐 온도 자동 보정 항목; PID 보정 완료 후 주석 처리됨
#pid_kp = 26.213              # PID 노즐 온도 자동 보정 항목; PID 보정 완료 후 주석 처리됨
#pid_ki = 1.304               # PID 노즐 온도 자동 보정 항목; PID 보정 완료 후 주석 처리됨
#pid_kd = 131.721             # PID 노즐 온도 자동 보정 항목; PID 보정 완료 후 주석 처리됨

#--------------------------------------------------------------------
[tmc2208 extruder]                  # 익스트루더 드라이버 설정
uart_pin: PG6                      # UART 포트 핀 정의
interpolate: False                  # 256 마이크로스텝 보간 사용 여부; True는 켬, False는 끔
run_current: 0.8                    # 모터 구동 전류
sense_resistor: 0.110               # 드라이버 sense 저항은 변경하지 마십시오
#stealthchop_threshold: 500          # stealthChop 임계값; 익스트루더에는 권장하지 않으며 저소음이 필요 없으면 0으로 설정

#####################################################################
#                     E1 익스트루더 설정 （E1 Settings）                   #
#####################################################################

[extruder1]
nozzle_diameter: 0.400              # 노즐 직경
filament_diameter: 1.75             # 필라멘트 직경
heater_pin: PF6                     # 히터 카트리지 핀
sensor_type: ATC Semitec 104GT-2    # 센서 유형  (#Generic 3950, ATC Semitec 104GT-2， PT1000)
sensor_pin: PC1                     # 센서 핀, ADC_0에 연결
min_temp: -273                      # 최소 온도; 측정 온도가 설정 범위를 벗어나면 긴급 정지 트리거
max_temp: 350                       # 최대 온도; 측정 온도가 설정 범위를 벗어나면 긴급 정지 트리거
max_power: 1.0                      # 최대 출력
min_extrude_temp: 180               # 최소 압출 온도; 이 온도 이상이어야 익스트루더가 압출 가능
#노즐 온도 PID 보정 명령：  "PID_CALIBRATE HEATER=extruder1 TARGET=245
#control = pid                # PID 노즐 온도 자동 보정 항목; PID 보정 완료 후 주석 처리됨
#pid_kp = 26.213              # PID 노즐 온도 자동 보정 항목; PID 보정 완료 후 주석 처리됨
#pid_ki = 1.304               # PID 노즐 온도 자동 보정 항목; PID 보정 완료 후 주석 처리됨
#pid_kd = 131.721             # PID 노즐 온도 자동 보정 항목; PID 보정 완료 후 주석 처리됨

#####################################################################
#                     E2 익스트루더 설정 （E2 Settings）                   #
#####################################################################

[extruder2]
nozzle_diameter: 0.400              # 노즐 직경
filament_diameter: 1.75             # 필라멘트 직경
heater_pin: PE6                     # 히터 카트리지 핀
sensor_type: ATC Semitec 104GT-2    # 센서 유형  (#Generic 3950, ATC Semitec 104GT-2， PT1000)
sensor_pin: PC0                     # 센서 핀, ADC_0에 연결
min_temp: -273                      # 최소 온도; 측정 온도가 설정 범위를 벗어나면 긴급 정지 트리거
max_temp: 350                       # 최대 온도; 측정 온도가 설정 범위를 벗어나면 긴급 정지 트리거
max_power: 1.0                      # 최대 출력
min_extrude_temp: 180               # 최소 압출 온도; 이 온도 이상이어야 익스트루더가 압출 가능
#노즐 온도 PID 보정 명령：  "PID_CALIBRATE HEATER=extruder2 TARGET=245
#control = pid                # PID 노즐 온도 자동 보정 항목; PID 보정 완료 후 주석 처리됨
#pid_kp = 26.213              # PID 노즐 온도 자동 보정 항목; PID 보정 완료 후 주석 처리됨
#pid_ki = 1.304               # PID 노즐 온도 자동 보정 항목; PID 보정 완료 후 주석 처리됨
#pid_kd = 131.721             # PID 노즐 온도 자동 보정 항목; PID 보정 완료 후 주석 처리됨

#####################################################################
#                     E3 익스트루더 설정 （E3 Settings）                   #
#####################################################################

[extruder3]
nozzle_diameter: 0.400              # 노즐 직경
filament_diameter: 1.75             # 필라멘트 직경
heater_pin: PE5                     # 히터 카트리지 핀
sensor_type: ATC Semitec 104GT-2    # 센서 유형  (#Generic 3950, ATC Semitec 104GT-2， PT1000)
sensor_pin: PF10                    # 센서 핀, ADC_0에 연결
min_temp: -273                      # 최소 온도; 측정 온도가 설정 범위를 벗어나면 긴급 정지 트리거
max_temp: 350                       # 최대 온도; 측정 온도가 설정 범위를 벗어나면 긴급 정지 트리거
max_power: 1.0                      # 최대 출력
min_extrude_temp: 180               # 최소 압출 온도; 이 온도 이상이어야 익스트루더가 압출 가능
#노즐 온도 PID 보정 명령：  "PID_CALIBRATE HEATER=extruder3 TARGET=245
#control = pid                # PID 노즐 온도 자동 보정 항목; PID 보정 완료 후 주석 처리됨
#pid_kp = 26.213              # PID 노즐 온도 자동 보정 항목; PID 보정 완료 후 주석 처리됨
#pid_ki = 1.304               # PID 노즐 온도 자동 보정 항목; PID 보정 완료 후 주석 처리됨
#pid_kd = 131.721             # PID 노즐 온도 자동 보정 항목; PID 보정 완료 후 주석 처리됨

#####################################################################
#                            히트베드 설정                                #
#####################################################################

[heater_bed]
heater_pin: PE3              # 히트베드 포트
sensor_type: Generic 3950    # 히트베드 센서 유형
sensor_pin:  PF3             # 히트베드 센서 포트
max_power: 1.0               # 히트베드 출력
min_temp: -273                  # 최소 온도; 측정 온도가 설정 범위를 벗어나면 긴급 정지 트리거
max_temp: 100                # 최대 온도; 측정 온도가 설정 범위를 벗어나면 긴급 정지 트리거
# 히트베드 온도 PID 보정 명령：  "PID_CALIBRATE HEATER=heater_bed TARGET=100"
#control: pid                # PID 히트베드 온도 자동 보정 항목; PID 보정 완료 후 주석 처리됨
#pid_kp: 58.437              # PID 히트베드 온도 자동 보정 항목; PID 보정 완료 후 주석 처리됨
#pid_ki: 2.347               # PID 히트베드 온도 자동 보정 항목; PID 보정 완료 후 주석 처리됨
#pid_kd: 363.769             # PID 히트베드 온도 자동 보정 항목; PID 보정 완료 후 주석 처리됨

#####################################################################
#                            팬 설정                                #
#####################################################################
[fan]                        # 파트 냉각 팬
pin: PF8                     # 신호 포트
kick_start_time: 0.5         # 시작 시간; 변경하지 마십시오
off_below: 0.10              # 변경하지 마십시오
#--------------------------------------------------------------------
[heater_fan hotend_fan]
pin: PF9                     # 신호 포트
max_power: 1                 # 최대 속도
kick_start_time: 0.5         # 시작 시간; 변경하지 마십시오
heater: extruder,extruder1,extruder2,extruder3             # 연결 장치: 익스트루더
heater_temp: 50              # 팬이 시작되는 익스트루더 온도
fan_speed: 0.6               # 팬 속도
#--------------------------------------------------------------------
[heater_fan dock_fan]
pin: PA2                     # 신호 포트
max_power: 1.0               # 최대 속도
kick_start_time: 0.5         # 시작 시간; 변경하지 마십시오
heater: extruder,extruder1,extruder2,extruder3              # 연결 장치: 익스트루더
heater_temp: 50              # 팬이 시작되는 익스트루더 온도
fan_speed: 1.0               # 팬 속도
#--------------------------------------------------------------------

[controller_fan driver_fan]
pin: PA1                     # 실제 메인보드의 컨트롤러 팬 핀으로 변경
max_power: 1.0              # 팬 최대 출력
idle_timeout: 60            # 스테퍼 유휴 후 지연 시간(초)

#####################################################################
#                           레벨링 센서                               #
#####################################################################
[probe]
pin: PF2
x_offset: 2.88                  # 노즐 기준 센서 X축 오프셋
y_offset: 11.63                 # 노즐 기준 센서 Y축 오프셋
#z_offset: 5.07              # 노즐 기준 센서 Z축 오프셋
#PROBE_CALIBRATE, 프로브 보정
speed: 10                     # 레벨링 속도
samples: 3                   # 샘플 수
samples_result: median       # 샘플 결과 방식; 기본 median
sample_retract_dist: 3.0     # 레벨링 리트랙트 거리
lift_speed:8                # 상승 속도
samples_tolerance: 0.005     # 샘플 허용 오차; 너무 작으면 샘플 수가 늘어날 수 있음
samples_tolerance_retries: 6 # 허용 오차 초과 시 재시도 횟수

#####################################################################
#                               홈                                #
#####################################################################
[homing_override]
axes: z
set_position_z: 0
gcode:
    G91
    G1 Z10 F600
    G90

    # X가 홈 되었는지 확인하고, 아니면 홈 수행
    {% if "X" not in printer.toolhead.homed_axes %}
        G28 Y
        G91
        G1 Y-40 F2400
        G90
    {% endif %}
    M400

    # X가 홈 되었는지 확인하고, 아니면 홈 수행
    {% if "X" not in printer.toolhead.homed_axes %}
        G28 X
        G91
        G1 X-5 F1200
        G90
    {% endif %}

    UNTOOL  # 툴 언로드 매크로 실행

    # Z 홈을 위해 베드 중앙으로 이동; 베드 크기에 맞게 X150 Y150 조정
    G0 X{ printer.toolhead.axis_maximum.x/2 } Y{ printer.toolhead.axis_maximum.y/2 } F6000

    # 실제 Z 홈 수행
    G28 Z

    # 홈 후 약간 상승
    G1 Z20 F600

#####################################################################
#   3Z 레벨링
#####################################################################
[z_tilt]
# z_positions: 리드스크류의 물리 좌표, 회전 중심점
# 노즐이 리드스크류 바로 위로 이동할 수 있다고 가정했을 때의 XY 좌표입니다.
# 주의: 이 점들은 보통 출력 영역 밖에 있습니다.
z_positions:
    -10, -5           # 리드스크류 1(stepper_z) 물리 위치
    117.5, 255        # 리드스크류 2 (stepper_z1)  물리 위치
    245, 10           # 리드스크류 3(stepper_z2) 물리 위치

# points: 프로브가 측정하는 좌표점, 프로브가 베드에 닿는 지점
points:
    10, 10            # 첫 번째 측정점 (좌후방 리드스크류 근처)
    117.5, 205        # 두 번째 측정점 (우후방 리드스크류 근처)
    225, 10           # 세 번째 측정점 (전방 중앙 리드스크류 근처)

speed: 400            # 측정 사이 이동 속도
horizontal_move_z: 10 # 측정 전 상승 높이
retries: 6            # 정밀도에 도달할 때까지 허용되는 재시도 횟수
retry_tolerance: 0.01 # 정밀도 요구 사항
#####################################################################
#                              베드 메시 보정
#####################################################################
[bed_mesh]
speed: 300                   # 보정 속도
horizontal_move_z: 10        # 프로브가 다음 점으로 이동하기 전 필요한 Z 상승 높이
mesh_min: 10,10              # 최소 보정점 좌표 X, Y
mesh_max: 220, 225           # 최대 보정점 좌표 X, Y
probe_count: 5,5             # 샘플 지점 수; 4x4는 16점
mesh_pps: 2,2                # 보간 샘플 지점 수
algorithm: bicubic           # 알고리즘 모델
bicubic_tension: 0.2         # 알고리즘 보간 설정은 변경하지 마십시오

#####################################################################
#                    프로빙 전 활성 툴(핫엔드 모듈) 주차
#####################################################################
[gcode_macro Z_TILT_ADJUST]
rename_existing: Z_TILT_ADJUST_BASE
gcode:
    UNTOOL        # 먼저 툴이 없는지 확인
    Z_TILT_ADJUST_BASE {rawparams}  # 그 다음 원래 레벨링 명령 실행

[gcode_macro BED_MESH_CALIBRATE]
rename_existing: BED_MESH_CALIBRATE_BASE
gcode:
    UNTOOL        # 먼저 툴이 없는지 확인
    BED_MESH_CALIBRATE_BASE {rawparams} # 그 다음 원래 레벨링 명령 실행

#####################################################################
#                              가속도계
#####################################################################
[lis2dw]
i2c_address: 25
# i2c_mcu: toolhead          # 생략하면 메인 MCU 사용
# i2c_bus: i2c3              # 소프트웨어 I2C 실패 시 하드웨어 I2C 시도
i2c_speed: 400000
i2c_software_scl_pin: PA9
i2c_software_sda_pin: PA10

[resonance_tester]
accel_chip: lis2dw
accel_per_hz: 50
probe_points: 120, 120, 20   # 베드 중심과 약 20 mm의 안전한 Z 높이로 설정

[input_shaper]
# 공진 보정 후 SAVE_CONFIG가 값을 기록할 때까지 비워 둡니다.

#####################################################################
#                           사용자 G-code 매크로                            #
#####################################################################

[gcode_macro PRINT_START]
description: 출력 시작 매크로: 홈, 레벨링, 재료별 독립 온도 가열, 순차 프라이밍 라인
gcode:
    # ==========================================
    # 1. 프라이밍 라인 파라미터
    # ==========================================
    {% set cfg_start_x = params.START_X|default(10.0)|float %}
    {% set cfg_start_y = params.START_Y|default(5.0)|float %}
    {% set cfg_offset_y = params.OFFSET_Y|default(2.0)|float %}
    {% set cfg_length = params.LENGTH|default(50.0)|float %}
    {% set cfg_pre_extrude = params.PRE_EXTRUDE|default(3.0)|float %}
    {% set cfg_retract = 0 %}
    {% set cfg_speed_xy = 24000 %}
    {% set cfg_speed_z = 3000 %}

    # ==========================================
    # 2. 슬라이서 파라미터를 읽고 실제 사용하는 툴 식별
    # ==========================================
    {% set BED_TEMP = params.BED|default(60)|float %}
    {% set INITIAL_TOOL = params.INITIAL_TOOL|default("0")|string %}
    {% set ns = namespace(tools="", temps="") %}

    # 지원하는 슬라이서 슬롯 T0~T4를 확인합니다.
    {% for i in range(5) %}
        {% set temp_key = 'T' ~ i ~ '_TEMP' %}
        {% set used_key = 'T' ~ i ~ '_USED' %}
        {% set ext_name = "extruder" if i == 0 else "extruder" ~ i %}

        {% if temp_key in params and ext_name in printer.heaters.available_heaters %}
            {% set t_val = params[temp_key]|float %}
            {% set is_used = params[used_key]|default("1")|string|lower %}
            {% if t_val > 0 and (is_used == "1" or is_used == "true") %}
                {% set ns.tools = ns.tools ~ i ~ "," %}
                {% set ns.temps = ns.temps ~ t_val ~ "," %}
            {% endif %}
        {% endif %}
    {% endfor %}

    {% set tool_list = ns.tools.strip(',').split(',') %}
    {% set temp_list = ns.temps.strip(',').split(',') %}

    # 유효한 툴이 없으면 초기 툴만 200 C로 가열합니다.
    {% if tool_list|length == 1 and tool_list[0] == "" %}
        {% set tool_list = [INITIAL_TOOL] %}
        {% set temp_list = [200.0] %}
    {% endif %}

    # ==========================================
    # 3. 베드 예열, 홈, 레벨링
    # ==========================================
    BED_MESH_CLEAR
    M140 S{BED_TEMP}
    G28
    Z_TILT_ADJUST
    G28 Z
    G1 Z20 F{cfg_speed_z}
    BED_MESH_PROFILE LOAD=default
    M190 S{BED_TEMP}

    # ==========================================
    # 4. 사용하는 모든 툴을 각각의 목표 온도로 가열
    # ==========================================
    # 모든 히터를 동시에 가열하기 시작합니다.
    {% for i in range(tool_list|length) %}
        {% if tool_list[i] != "" and temp_list[i] != "" %}
            M104 S{temp_list[i]} T{tool_list[i]}
        {% endif %}
    {% endfor %}

    # 각 히터가 목표 온도에 도달할 때까지 기다립니다.
    {% for i in range(tool_list|length) %}
        {% if tool_list[i] != "" and temp_list[i] != "" %}
            M109 S{temp_list[i]} T{tool_list[i]}
        {% endif %}
    {% endfor %}

    # ==========================================
    # 5. 툴을 순서대로 전환하고 프라이밍 라인 생성
    # ==========================================
    SAVE_GCODE_STATE NAME=print_start_state
    G90
    G92 E0
    {% set ns_line = namespace(line_index=0) %}

    # 5.1 초기 툴이 아닌 툴부터 프라이밍합니다.
    {% for tool in tool_list %}
        {% if tool != "" and tool != INITIAL_TOOL %}
            T{tool}
            {% set current_y = cfg_start_y + (ns_line.line_index * cfg_offset_y) %}

            G1 Z5.0 F{cfg_speed_z}
            G1 X{cfg_start_x} Y{current_y} F{cfg_speed_xy}
            G1 Z0.28 F1500

            G91
            G1 E{cfg_pre_extrude} F300
            G1 X{cfg_length * 0.6} E{cfg_length * 0.12} F1000
            G1 X{cfg_length * 0.4} E{cfg_length * 0.05} F1500
            G1 E-{cfg_retract} F2100
            G1 Z2.0 F{cfg_speed_z}

            G90
            G92 E0
            M104 S0 T{tool}
            {% set ns_line.line_index = ns_line.line_index + 1 %}
        {% endif %}
    {% endfor %}

    # 5.2 초기 툴을 마지막으로 프라이밍해 바로 출력할 수 있게 합니다.
    {% if INITIAL_TOOL in tool_list %}
        T{INITIAL_TOOL}
        {% set current_y = cfg_start_y + (ns_line.line_index * cfg_offset_y) %}

        G1 Z5.0 F{cfg_speed_z}
        G1 X{cfg_start_x} Y{current_y} F{cfg_speed_xy}
        G1 Z0.28 F1500

        G91
        G1 E{cfg_pre_extrude} F300
        G1 X{cfg_length * 0.6} E{cfg_length * 0.12} F1000
        G1 X{cfg_length * 0.4} E{cfg_length * 0.05} F1500
        G1 E-{cfg_retract} F2100
        G1 Z2.0 F{cfg_speed_z}

        G90
        G92 E0
    {% endif %}

    # ==========================================
    # 6. 상태를 복원하고 초기 툴 오프셋 적용
    # ==========================================
    RESTORE_GCODE_STATE NAME=print_start_state

    {% if INITIAL_TOOL in tool_list %}
        {% set svv = printer.save_variables.variables %}
        {% set off_x = svv["t" ~ INITIAL_TOOL ~ "_offset_x"] | default(0.0) | float %}
        {% set off_y = svv["t" ~ INITIAL_TOOL ~ "_offset_y"] | default(0.0) | float %}
        {% set off_z = svv["t" ~ INITIAL_TOOL ~ "_offset_z"] | default(0.0) | float %}

        SET_GCODE_OFFSET X={off_x} Y={off_y} Z={off_z} MOVE=0
        { action_respond_info("초기 툴 T" ~ INITIAL_TOOL ~ " 오프셋 적용: X=" ~ off_x ~ " Y=" ~ off_y ~ " Z=" ~ off_z) }
    {% endif %}

    { action_respond_info("프라이밍 완료. 현재 툴은 T" ~ INITIAL_TOOL ~ "이며 출력 준비가 끝났습니다.") }
#--------------------------------------------------------------------
[gcode_macro PRINT_END]
description: 출력 종료 매크로: 활성 툴 주차, 가열 끄기, 파트 제거를 위해 베드 하강
gcode:
    # 1. 프린터 설정 범위 가져오기
    {% set max_x = printer.configfile.config["stepper_x"]["position_max"]|float %}
    {% set max_y = printer.configfile.config["stepper_y"]["position_max"]|float %}
    {% set max_z = printer.configfile.config["stepper_z"]["position_max"]|float %}

    # 2. 활성 툴(핫엔드 모듈) 주차 및 오프셋 재설정
    UNTOOL
    SET_GCODE_OFFSET X=0 Y=0 Z=0

    M400                              # 버퍼가 비워질 때까지 대기
    G92 E0                            # 익스트루더 위치 카운터 초기화

    # 3. 먼저 상대 좌표로 작은 안전 상승 수행
    G91                               # 상대 좌표
    # 최대 높이를 넘지 않으면 5 mm 상승
    {% if printer.toolhead.position.z < (max_z - 5) %}
        G0 Z5 F3600
    {% endif %}

    # 4. 모든 히터와 팬 끄기
    M104 S0 T0
    M104 S0 T1
    M104 S0 T2
    M104 S0 T3
    M140 S0                           # 히트베드 끄기
    M106 S0                           # 파트 냉각 팬 끄기

    # 5. 절대 좌표로 파트 제거 위치 이동 수행
    G90                               # 절대 좌표로 전환
    {% set safe_z = max_z - 10 %}

    G0 X{max_x-5} Y{max_y-5} Z{safe_z} F6000

    # 6. 후처리
    M400                              # 이동 완료 대기
    BED_MESH_CLEAR                    # 베드 메시 해제
    # M84                             # 선택 사항: 수동 파트 제거를 쉽게 하려면 이 줄 주석을 해제해 모터를 끌 수 있습니다

    { action_respond_info("출력이 완료되었습니다. 베드가 내려갔으니 파트를 제거하십시오.") }
#*# <---------------------- SAVE_CONFIG ---------------------->
#*# DO NOT EDIT THIS BLOCK OR BELOW. The contents are auto-generated.
#*#
#*# [heater_bed]
#*# control = pid
#*# pid_kp = 18.892
#*# pid_ki = 0.396
#*# pid_kd = 225.286
#*#
#*# [extruder]
#*# control = pid
#*# pid_kp = 23.799
#*# pid_ki = 6.102
#*# pid_kd = 23.204
#*#
#*# [probe]
#*# z_offset = -1.225
#*#
#*# [extruder1]
#*# control = pid
#*# pid_kp = 26.493
#*# pid_ki = 8.831
#*# pid_kd = 19.870
#*#
#*# [extruder2]
#*# control = pid
#*# pid_kp = 46.880
#*# pid_ki = 10.081
#*# pid_kd = 54.499
#*#
#*# [extruder3]
#*# control = pid
#*# pid_kp = 40.250
#*# pid_ki = 13.417
#*# pid_kd = 30.187
#*#
#*# [bed_mesh default]
#*# version = 1
#*# points =
#*# 	  -0.014690, -0.052190, -0.025940, -0.054690, -0.050940
#*# 	  -0.052190, -0.025940, -0.010940, -0.010940, 0.004060
#*# 	  -0.120940, -0.043440, -0.013440, 0.030310, 0.100310
#*# 	  -0.197190, -0.100940, -0.027190, 0.055310, 0.155310
#*# 	  -0.245940, -0.087190, 0.022810, 0.120310, 0.264060
#*# x_count = 5
#*# y_count = 5
#*# mesh_x_pps = 2
#*# mesh_y_pps = 2
#*# algo = bicubic
#*# tension = 0.2
#*# min_x = 10.0
#*# max_x = 220.0
#*# min_y = 10.0
#*# max_y = 225.0
#*#
#*# [input_shaper]
#*# shaper_type_x = mzv
#*# shaper_freq_x = 94.4
#*# shaper_type_y = mzv
#*# shaper_freq_y = 66.4
