SukbeomH/CxChanger/(commit log)

2026-04-24 Update hardware requirements section in README
    Clarified printer compatibility and added details on dock design requirements.
2026-04-27 统一隔离柱高度到10mm方便购买零件
2026-05-02 Refactor tool change configuration and macros
    [toolchange.cfg]
2026-05-11 Fix typo in README for round head pin dimensions
2026-05-25 Update README to reference BOM instead of CNC parts list
    Removed detailed CNC component list and replaced it with a reference to the BOM table.
2026-06-09 Rename project from Simple-Multi-Hotend to CxChanger
2026-07-12 Translate Klipper configs and normalize filenames
    [5.1-backplate-2.5mm-belt-slot.step, 5.1-cover-plate-PB1.step, 5.1-idler-arm-PB2-thread-recognizable.step, 5.5-version-bom.xlsx, calibration.cfg, printer.cfg, toolchange.cfg]
2026-07-12 Standardize OrcaSlicer terminology
    [printer.cfg, toolchange.cfg]
2026-07-12 Translate remaining Chinese project text
    [calibration.cfg, printer.cfg, toolchange.cfg]
2026-07-18 Sync latest upstream configuration updates
    [printer.cfg, toolchange.cfg]
